WHITE-ICE-BOX/MARS-Reconfigurable-Multi-Task-Capable-Accelerator-for-Ultra-Low-Bit-Streaming-Inference/02_圖片原始檔/ch4/fig4.7_rc_in_hardware.pptx

RC In Hardware — Folded Into The Accumulator Initial Value

no extra adder / stage

“+ RC” adder

Window Start → sel init

hidden_acc
register

Stream in

M
U
X

hidden_act [1b]

Sign

Input
Buffer

[SIMD]

XNOR
[SIMD]

Popcount

+

Weights

Accumulate Loop

RC = initial value

Parameter Write
(From Function Switch Controller)

ram_down

ram_rc

The register must load an initial value every window anyway — RC simply replaces 0.
Datapath unchanged: 0 extra adders, 0 DSP, 0 pipeline stages. Cost = ram_rc storage only.
