WHITE-ICE-BOX/MARS-Reconfigurable-Multi-Task-Capable-Accelerator-for-Ultra-Low-Bit-Streaming-Inference/02_圖片原始檔/ch4/fig4.1_mars_soc.pptx

BUS

MARS NPU

DDR

SoC

Micro Processor

DDR Controller

Input DMA

Function Switch Controller

Output DMA
