WHITE-ICE-BOX/MARS-Reconfigurable-Multi-Task-Capable-Accelerator-for-Ultra-Low-Bit-Streaming-Inference/02_圖片原始檔/ch4/fig4.3_mars_arch.pptx

Configuration Bus

PS

Micro
Processor

Function
Switch
Controller

PL

MVAU8

DRAM

Output

Images

Super4

Super5

MVAU6

MVAU7

MaxPool

Super3

Super2

MaxPool

Super1

MVAU0
