WHITE-ICE-BOX/MARS-Reconfigurable-Multi-Task-Capable-Accelerator-for-Ultra-Low-Bit-Streaming-Inference/02_圖片原始檔/ch4/fig4.9_fsc_circuit.pptx

Function Switch Controller (adapter_cfg_hub.v)

MVAU0 Thresh

AWADDR[15:0]

Function Switch Controller

MVAU8 Cls Weights

AW latch

16

Unit decode
a[15:13]

3

WE demux
1-of-9

Super 1 Adapter

AWVALID

Unit-0 split
a[12]

9

Super 2 Adapter

WVALID

Write FSM

Word slice
a[12:2]

Super 3 Adapter

WDATA[31:0]

Configuration BUS
(waddr·wdata)

Super 4 Adapter

Super 5 Adapter

BRESP

MVAU6 Thresh

MVAU7 Thresh
