WHITE-ICE-BOX/MARS-Reconfigurable-Multi-Task-Capable-Accelerator-for-Ultra-Low-Bit-Streaming-Inference/02_圖片原始檔/ch5/fig5.1_hw_end2end.pptx

Model Construction

Frozen Backbone

Multi-Branch Adapter
with RC task #1

Multi-Branch Adapter
with RC task #N

Build AI Model

Train Backbone
+ Adapters

Evaluation

FINN Compiler

Model Deployment

Backbone IP

Super Wrapper

Function Switch Controller

⋮

Deploy
