WHITE-ICE-BOX/MARS-Reconfigurable-Multi-Task-Capable-Accelerator-for-Ultra-Low-Bit-Streaming-Inference/01_論文全文/figures/mb_tradeoff_compact_power.pdf

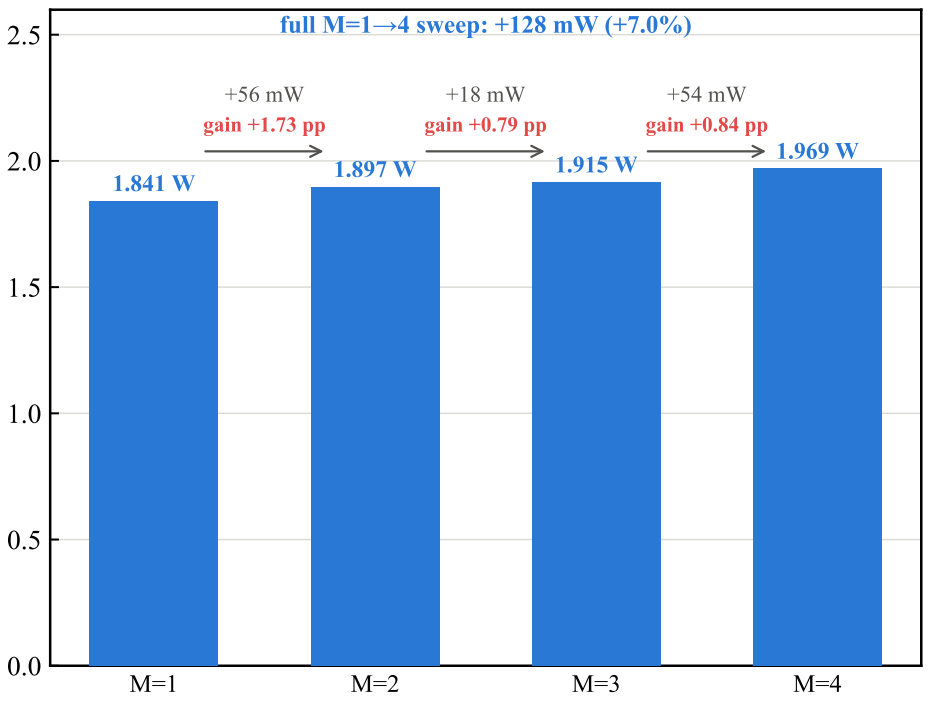
[picture p18: figure]
+56 mW gain +1.73 pp; +18 mW gain +0.79 pp; +54 mW gain +0.84 pp; full M=1 4 sweep: +128 mW (+7.0%)

### Total on-chip power (W, post-synthesis estimate)
