WHITE-ICE-BOX/MARS-Reconfigurable-Multi-Task-Capable-Accelerator-for-Ultra-Low-Bit-Streaming-Inference/01_論文全文/figures/mb_tradeoff_throughput_power.pdf

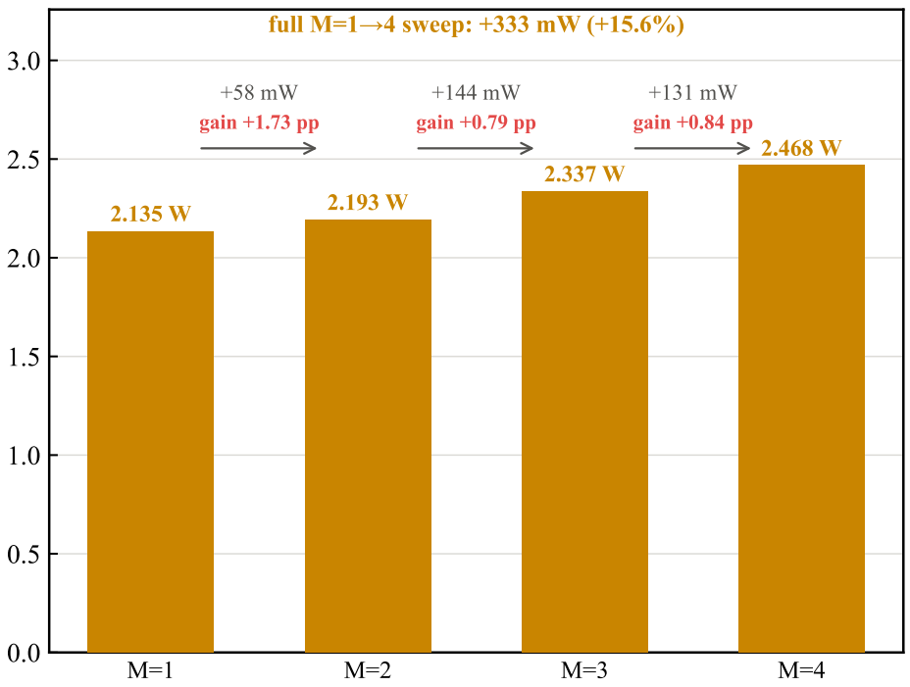
[picture p19: figure]
+58 mW gain +1.73 pp; +144 mW gain +0.79 pp; +131 mW gain +0.84 pp; full M=1 4 sweep: +333 mW (+15.6%)

### Total on-chip power (W, post-synthesis estimate)
