WHITE-ICE-BOX/MARS-Reconfigurable-Multi-Task-Capable-Accelerator-for-Ultra-Low-Bit-Streaming-Inference/07_碩士口試/README.md

# 07_碩士口試

- `黃柏鈞_MARS_口試簡報.pptx`：碩士論文口試簡報（最新版）。全英文、Times New Roman;涵蓋
  問題背景、MARS 方法（multi-branch adapter / RC / cfg_hub 任務切換）、實驗結果與跨平台比較、
  FPGA 量測條件與 SOTA 對照。
