WHITE-ICE-BOX/MARS-Reconfigurable-Multi-Task-Capable-Accelerator-for-Ultra-Low-Bit-Streaming-Inference/02_圖片原始檔/ch3/README.md

# ch3 圖片原始檔

架構示意圖編輯檔（pptx,已附）:

| Fig | 名稱 | 編輯檔 |
|---|---|---|
| 3.1 | sw_network | `fig3.1_sw_network.pptx` ✓ |
| 3.2 | sw_single_adapter | `fig3.2_sw_single_adapter.pptx` ✓ |
| 3.3 | sw_multiadapter | `fig3.3_sw_multiadapter.pptx` ✓ |
