WHITE-ICE-BOX/MARS-Reconfigurable-Multi-Task-Capable-Accelerator-for-Ultra-Low-Bit-Streaming-Inference/02_圖片原始檔/ch5/README.md

# ch5 圖片原始檔

| Fig | 名稱 | 編輯檔 |
|---|---|---|
| 5.1 | hw_end2end | `fig5.1_hw_end2end.pptx` ✓ |
| 5.2 | rc_mechanism | `rc_probe_fig5_2.py`（GPU 端探查）+ `plot_rc_mechanism_fig5_2.py`（繪圖）+ `rc_probe_out.json`（數據）✓ |
| 5.3 | mars_soc_layout | Vivado implemented design 截圖（Vivado GUI 匯出,非 pptx）|
| 5.4 | pe_diff | `fig5.4_pe_diff.pptx` ✓ |
| 5.5 / 5.6 | mb_tradeoff（4 圖）| `plot_fig5_4_5_5.py` ✓ |
