WHITE-ICE-BOX/MARS-Reconfigurable-Multi-Task-Capable-Accelerator-for-Ultra-Low-Bit-Streaming-Inference/02_圖片原始檔/ch4/README.md

# ch4 圖片原始檔

架構示意圖編輯檔（pptx,已附）。編號依論文正文圖號;其中 Fig 4.8、4.10、4.12 原為 TikZ 內嵌圖,
已自論文 `01_論文全文/MARS_碩士論文.tex` 抽出為可獨立編譯的 standalone `.tex` 原始檔
（`pdflatex 檔名.tex` 即可出圖）,內容與論文原始碼一致,無 pptx。

| Fig | 名稱 | 編輯檔 |
|---|---|---|
| 4.1 | mars_soc（fig42_mars_soc）| `fig4.1_mars_soc.pptx` ✓ |
| 4.2 | hw_finn_singletask_npu | `fig4.2_hw_finn_singletask_npu.pptx` ✓ |
| 4.3 | mars_arch（fig44_mars_arch）| `fig4.3_mars_arch.pptx` ✓ |
| 4.4 | hw_finn_mvau_wrapper | `fig4.4_hw_finn_mvau_wrapper.pptx` ✓ |
| 4.5 | hw_super_wrapper | `fig4.5_hw_super_wrapper.pptx` ✓ |
| 4.6 | hw_adapter_internal | `fig4.6_hw_adapter_internal.pptx` ✓ |
| 4.7 | rc_in_hardware | `fig4.7_rc_in_hardware.pptx` ✓ |
| 4.8 | cfg_hub 系統整合圖 | `fig4.8_cfghub_sys.tex`（TikZ standalone）✓ |
| 4.9 | fsc_circuit | `fig4.9_fsc_circuit.pptx` ✓ |
| 4.10 | cfg_hub 64KB 位址映射 | `fig4.10_cfghub_map.tex`（TikZ standalone）✓ |
| 4.11 | task_switch | `fig4.11_task_switch.pptx` ✓ |
| 4.12 | 部署成本 vs 任務/變體數（pgfplots）| `fig4.12_scaling_cost.tex`（TikZ standalone）✓ |
