WHITE-ICE-BOX/MARS-Reconfigurable-Multi-Task-Capable-Accelerator-for-Ultra-Low-Bit-Streaming-Inference/05_程式碼/FINN_Compile/README.md

# FINN_Compile — FINN end-to-end dataflow 合成

在 **FINN（Docker）** 內，把訓練好的 1W1A CNV backbone 從 Brevitas 匯出成 ONNX，再經 FINN 的
**streamline → 轉硬體層 → 折疊（folding）→ dataflow 合成**，產出每個 MVAU 的 memblock 與
**StreamingDataflowPartition IP**，作為 `RTL/` 整合 Adapter 的輸入。

> **FINN 本體未做任何修改**：使用官方 **FINN v0.9 Docker 原樣**。唯一客製在**最前端**——
> 載入的模型（`model/CNV.py` 自訓 1W1A 檢查點）與輸入前處理；其後 streamline、轉硬體層、
> 折疊、`ZynqBuild` **全部是官方轉換、與官方 `cnv_end2end_example` 相同**。本夾各 notebook
> 皆為該官方範例之衍生（僅前端載入不同、或折疊參數不同），並非多套流程。
> FINN **產出之 RTL** 的最小手動補丁（暴露 partial sum，`RTL/gen_scripts/patch_finn_ips.py`）
> 施加於產生碼快照上、在 FINN 之外進行——不修改 FINN 套件本身。

> **MVAU** = Matrix-Vector-Activation Unit（FINN 的卷積/全連接運算單元）。
> **folding / PE** = 平行折疊度；PE 越大越快、面積越大。throughput build 用異質高 PE，compact build 用 PE=1。

---

## 一、結構樹

```
FINN_Compile/
├── notebooks/                       # ── FINN end-to-end 流程（Jupyter）──
│   ├── pe1_cnv_end2end.ipynb        #  ★ 最終 compact(PE=1) 硬體的 backbone end2end（5資料集 build 用）
│   ├── pe1_adapter.ipynb            #  ★ 最終 compact(PE=1) 的 adapter 側 end2end
│   ├── cnv_end2end_example.ipynb    #    high-PE（throughput build）的 backbone end2end
│   └── adapter.ipynb                #    high-PE 的 adapter 側 end2end
├── model/                           # ── FINN 的輸入模型 ──
│   ├── CNV.py                       #    Brevitas CNV 定義（匯出成 ONNX 的來源）
│   └── cnv_6layer_fc3_cifar_w1a1.zip#    訓練好的 CIFAR-10 1W1A 模型（end2end 載入這個）
├── scripts/                         # ── 輔助腳本 ──
│   ├── verify_finn_stages.py        #    驗證 FINN 各階段 ONNX 輸出正確性
│   ├── verify_cifar1w1a.py          #    CIFAR-10 1W1A 端到端正確性檢查
│   ├── validate_custom.py           #    自訂資料集驗證
│   └── dump_canonical_cifar.py      #    匯出標準 CIFAR-10 測資供比對
└── onnx/                            # ── FINN 合成的關鍵中間/輸出 ONNX ──
    ├── end2end_cnv_w1a1_dataflow_model.onnx  #  dataflow 階段（含折疊資訊）
    └── end2end_cnv_w1a1_folded.onnx          #  折疊後模型（合成前最終形態）
```

★ = 產出論文最終硬體所用的關鍵檔。

---

## 二、「最終硬體」是用哪個 end2end？（實際部署對照）

**實際產出上板 bitstream 的只有四本**；逐格與建置樹比對後的部署脈絡：

| 最終 build（上板） | 實際使用的 notebook | 折疊 | 說明 |
|---|---|---|---|
| backbone, throughput | `cnv_end2end_example.ipynb` | 異質 PE（官方預設） | 官方範例原流程;所有後續模型之母體（build tree `finn_cifar10`） |
| **MARS, throughput, 2-task** | `adapter.ipynb` | 異質 PE | = 官方範例前端改載入 adapter 時代之 `model/CNV.py` 檢查點,其後步驟同官方 |
| backbone, compactness (PE=1) | `pe1_cnv_end2end.ipynb` | 均勻 PE=1 | = 官方範例之複製,**僅折疊表改全 PE=1**（載入同一 `dataflow_model.onnx` 重折疊）;以 `jupyter nbconvert --execute` 無頭執行 |
| **MARS, compactness, N-task** | `pe1_adapter.ipynb` | 均勻 PE=1 | = `adapter.ipynb` 之 PE=1 對應版（22 格中 20 格相同,僅折疊不同） |

> 本夾**只保留實際產出上板 bitstream 的四本 notebook**。早期未用於部署的檔案（`backbone_cifar.ipynb` broken legacy、`pe1_refold_from_v1.py` 早期 refold 嘗試）已移除,避免誤導;PE=1 折疊實際在 `pe1_cnv_end2end.ipynb` 的折疊 cell 內完成。

---

## 三、完整 FINN 階段（ONNX 命名對應）

```
export → tidy → streamlined → (convert to HW layers) → folded → dataflow_model → synth
```
本資料夾只保留 `dataflow_model` 與 `folded` 兩個關鍵 ONNX（其餘中間檔與 Vivado `code_gen`
產物數十 GB，未收錄）。完整重跑請在 FINN Docker 內依 `notebooks/` 執行。

---

## 四、與 RTL 的銜接

FINN 產出每個 MVAU 的 memblock `.dat` 與 StreamingDataflowPartition IP 之後，`RTL/` 會把
MVAU1–5 各包一層 Adapter「Super Wrapper」、加入 `cfg_hub`，再以 `RTL/tcl/` 打包成 Vivado IP，
最後由 `SoC/` 縫合成 bitstream。
