WHITE-ICE-BOX/MARS-Reconfigurable-Multi-Task-Capable-Accelerator-for-Ultra-Low-Bit-Streaming-Inference/02_圖片原始檔/ch3/fig3.1_sw_network.pptx

Multi – Branch Adapter , RC

Conv2

Multi – Branch Adapter , RC

Conv3

Multi – Branch Adapter , RC

Conv4

Input

Conv1

MaxPool

MaxPool

Conv5

Conv6

FC1

FC2

LS

Output

Multi – Branch Adapter , RC

Multi – Branch Adapter , RC
