WHITE-ICE-BOX/MARS-Reconfigurable-Multi-Task-Capable-Accelerator-for-Ultra-Low-Bit-Streaming-Inference/02_圖片原始檔/ch3/fig3.3_sw_multiadapter.pptx

Down-projection

Sign

Up-projection

scale

× α1

sum

Cin

1×1 binary conv

b1 (RC)

binarize

1×1 binary conv

z⁽¹⁾

Cout

Ch = Cin / 4

b2 (RC)

z⁽²⁾

× α2

Σ

⋮

bM (RC)

z(M)

× αM
