WHITE-ICE-BOX/MARS-Reconfigurable-Multi-Task-Capable-Accelerator-for-Ultra-Low-Bit-Streaming-Inference/02_圖片原始檔/ch4/fig4.5_hw_super_wrapper.pptx

Super Wrapper

Modified MVAU Core
Binary Conv (XNOR-Popcount)

Splitter
Duplicate

Adder + Threshold
Sum Two Streams → 1-bit out

INPUT
Stream

OUTPUT
Stream

Adapter
Down→Sign→Up, +RC

FIFO
Sync

Multi-Branch Adapter — M parallel branches (M = 1–4)
