WHITE-ICE-BOX/MARS-Reconfigurable-Multi-Task-Capable-Accelerator-for-Ultra-Low-Bit-Streaming-Inference/02_圖片原始檔/ch4/fig4.6_hw_adapter_internal.pptx

s_axis_tvalid

s_axis_tdata

m_axis_tready

Control Unit

Adapter Memories (RAM)

ram_down

ram_rc

ram_up

contrib_lut

Adapter Datapath

[SIMD]

Input Buffer

XNOR + popcount (down)

Accumulator + RC

Sign → hidden_act

XNOR + popcount (up)

α-LUT → contrib

[SIMD]

s_axis_tready

[16b]

cfg_wen

cfg_waddr [11]

cfg_wdata [32]

[HIDDEN]

[HIDDEN]

m_axis_tvalid

m_axis_tdata

[32b]

[8b]
