WHITE-ICE-BOX/MARS-Reconfigurable-Multi-Task-Capable-Accelerator-for-Ultra-Low-Bit-Streaming-Inference/05_程式碼/AI_model_train/results/README.md

# results/ — 軟體實驗數據對照

> **數字對照**：各 `results/*.csv` 為 runner 原始輸出;`final_accuracy_summary.txt` 為彙整索引（從訓練 log
> 擷取的 Final Best Accuracy）。各 `results.csv` 為各 runner 的原始批次輸出，**僅供原始紀錄**；
> 論文數據以成功列與〈論文對應表〉為準;探索性或被取代之幾何列保留供 provenance。

## 一、資料夾 → 論文表 對照

| 資料夾 | 對應內容（論文） | 幾何 |
|---|---|---|
| `results.csv`（頂層） | CIFAR-10→SVHN 1-bit：adapter 73.72 / full-FT 94.91 / bit-sweep | — |
| `cifar10_configC_bits{,_rc}/` | CIFAR→targets 位元寬度掃描（單 Adapter no-RC / 含 RC） | 寬版（wide） |
| `cifar10_configC_cross/` | CIFAR backbone → 各 target 1-bit 多分支 Adapter | 寬版（wide） |
| `cifar10_to_others_bits/` | CIFAR→targets 位元掃描（含 full-FT 上界） | — |
| `svhn_to_others_bits/` | 跨來源位元寬度掃描 | — |
| `a6000_crosssource/*_configC_cross/` | **跨來源 1-bit 多分支 Adapter（Table「跨來源多分支 Adapter」）** | 寬版（wide） (mid='out') |
| `configC_sw_multi/` | 軟體多分支 Adapter 補格（CIFAR→{Fashion,STL10,CINIC10}, M2–4） | 寬版（wide） |
| `v6/ v_v6_bit/ v_v6_cross/ v_v6_cross_m/` | 寬版（wide）幾何（v6）各掃描 | 寬版（wide） |
| `v7_multi_rc/` | 多分支 Adapter × RC 開關消融；**deployed(v1v2) SVHN M1–4=73.72/77.16/78.77/79.81** | 寬版（wide） + deployed |
| `v9_cross_dataset/` | **deployed 跨資料集（CINIC10 M2–4=65.16/65.38/65.45）** | deployed |
| `v9_ft_baseline/ v9ft_cross_bit/` | full-FT 上界（1-bit 與位元寬度） | — |
| `v3_compare/ v3_compare_50ep_*/` | kernel 3×3 vs 1×1 單軸消融 | — |
| `v_seed/` | n=3 multi-seed 變異 | — |
| `b2_significance/` | n=5 paired t-test 顯著性 | deployed |
| `{svhn,stl10,fashionmnist}_to_others/` | **雙重角色**：`full_ft` 列＝Table 5.4 full-FT 欄來源（**採用**，如 SVHN→CIFAR10=81.70）；`adapter` 列為 mid='in'（**已被 configC 取代，勿用於多分支 Adapter 表**） | full_ft 採用 / adapter mid='in' 棄用 |

## 二、幾何（geometry）說明

- **寬版（wide）**（軟體參考（寬版））：kernel 3×3、mid='out'（Cout/4）、α per-channel。`configC` / `v6` 家族。
- **deployed**（FPGA 部署版）：kernel 1×1、mid='in'（Cin/4）、α scalar。`v9` 家族 + `b2`。
- `*_to_others/` 的 **adapter 列**是早期 **mid='in'** 跨來源跑，與論文 Table（寬版（wide）/mid='out'）
  幾何不同、數值也不同（例 SVHN→CINIC10 M4：mid='in'=36.7 vs 寬版（wide）=39.70），故 adapter 列**不採用**；
  但同資料夾的 **full_ft 列**為 Table 5.4 full-FT 欄之來源（**採用**）。跨來源多分支 Adapter 數值請看
  `a6000_crosssource/*_configC_cross/`（mid='out'）。

## 三、已知資料衛生問題（誠實標註）

- **headline 數字部分只在 summary**：如 寬版（wide） SVHN M4 = **84.44%**、CINIC10 M4 = **65.02%**
  為 seed-2024 單次跑，記錄於 `final_accuracy_summary.txt` 與 log，**未進結構化 CSV**。
- **探索/provenance 列**：少數早期或被取代之幾何列（`acc=0.0` 等）保留供追溯;論文值以對應表列為準。
- **`configC_sw_multi/results.csv`** 無 SVHN 列、CINIC10 M4 為空（補格用，SVHN 主表在 `v7_multi_rc`）。

---

## A6000 批次增補（論文定稿版新增，2026-07 同步）

| 目錄 | 對應論文 | 說明 |
|---|---|---|
| `b2_significance/` | Table 5.6、§5.2.5 | SVHN/FashionMNIST × M1/M4 × 5 seeds（2024–2028）配對檢定原始值 |
| `table56_5seed/` | Table 5.5 | Full-FT 與 MARS M4+RC 各 5 seeds |
| `{svhn,stl10,fashionmnist,cinic10}_configA_cross/` | Table 5.18（部署 20 對之 16 對） | 各來源 backbone × 4 targets × M1–4（RC on）；CIFAR-10 來源之 4 對見 `v9_cross_dataset/` |
| `*_configA_bits_rc/` | Table 5.8–5.10 佐證 | 部署幾何 RC 消融跨位元 |
| `fashionmnist_configA_verify/`、`fashionmnist_configC_SVHN_{200ep,verify}/` | §5.3.4 | FMNIST→SVHN 幾何反轉之獨立重跑／seed2025／50ep 驗證（舊 45.68 重複值＝best-epoch 峰值碰撞，論文 Table 5.4 † 註） |
| `cinic10_configC_{cross,bits_rc}/` | Table 5.4、3.2 | CINIC10 來源寬版掃描與位元掃描 |

注:2-bit 批次（`*_configC_cross2`,BIT=2）非論文數據,本 release 僅收錄論文相關之 1/2/4/8-bit 結果。

## 溯源(provenance)

- 所有 CSV 為 runner 直接輸出之原始值(未手改);對應 runner 之超參數(seed、epochs、lr、幾何旗標)寫死於 `runners/*.py` 內,即為該批數據之完整 configuration metadata。
- 訓練皆 200 epochs、STEP(100,150)、lr 0.005、batch 100;headline 用 seed 2024,多 seed 批次為 2024–2028。
- 本 release 對應之論文版本:碩士論文定稿(2026-07);程式碼與數據之對應以 git tag/commit 為準。
