WHITE-ICE-BOX/MARS-Reconfigurable-Multi-Task-Capable-Accelerator-for-Ultra-Low-Bit-Streaming-Inference/05_程式碼/AI_model_train/results/a6000_crosssource/b2_significance/results.csv

dataset | M | seed | best_acc
SVHN | 1 | 2024 | 73.01014136447449
