WHITE-ICE-BOX/MARS-Reconfigurable-Multi-Task-Capable-Accelerator-for-Ultra-Low-Bit-Streaming-Inference/05_程式碼/AI_model_train/results/a6000_crosssource/cinic10_configC_bits_rc/results.csv

dataset | bit | mode | acc | params | returncode
CIFAR10 | 8 | adapter_rc | 90.54 | 1875423 | 0
FashionMNIST | 8 | adapter_rc | 93.77 | 1875423 | 0
STL10 | 8 | adapter_rc | 74.19 | 1875423 | 0
SVHN | 8 | adapter_rc | 95.72 | 1875423 | 0
