WHITE-ICE-BOX/MARS-Reconfigurable-Multi-Task-Capable-Accelerator-for-Ultra-Low-Bit-Streaming-Inference/05_程式碼/AI_model_train/results/a6000_crosssource/fashionmnist_configA_bits_rc/results.csv

dataset | bit | mode | acc | params | returncode
CINIC10 | 1 | adapter_rc | 27.75 | 1605223 | 0
CINIC10 | 2 | adapter_rc | 32.55 | 1605231 | 0
CINIC10 | 4 | adapter_rc | 37.73 | 1605231 | 0
CINIC10 | 8 | adapter_rc | 39.14 | 1605231 | 0
