WHITE-ICE-BOX/MARS-Reconfigurable-Multi-Task-Capable-Accelerator-for-Ultra-Low-Bit-Streaming-Inference/05_程式碼/AI_model_train/results/a6000_crosssource/fashionmnist_configA_cross/results.csv

dataset | mode | M | rc | acc | params | returncode
CINIC10 | adapter | 1 | True | 27.75 | 1605223 | 0
CINIC10 | adapter | 2 | True | 28.37 | 1663756 | 0
CINIC10 | adapter | 3 | True | 29.55 | 1722289 | 0
CINIC10 | adapter | 4 | True | 29.56 | 1780822 | 0
