WHITE-ICE-BOX/MARS-Reconfigurable-Multi-Task-Capable-Accelerator-for-Ultra-Low-Bit-Streaming-Inference/05_程式碼/AI_model_train/results/a6000_crosssource/fashionmnist_configC_bits_rc/results.csv

dataset | bit | mode | acc | params | returncode
CINIC10 | 1 | adapter_rc | 0.0 | 1875410 | 1
CINIC10 | 2 | adapter_rc | 0.0 | 1875423 | 1
CINIC10 | 4 | adapter_rc | 67.65 | 1875423 | 0
CINIC10 | 8 | adapter_rc | 68.84 | 1875423 | 0
