WHITE-ICE-BOX/MARS-Reconfigurable-Multi-Task-Capable-Accelerator-for-Ultra-Low-Bit-Streaming-Inference/01_論文全文/figures/mb_tradeoff_compact_lut.pdf

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

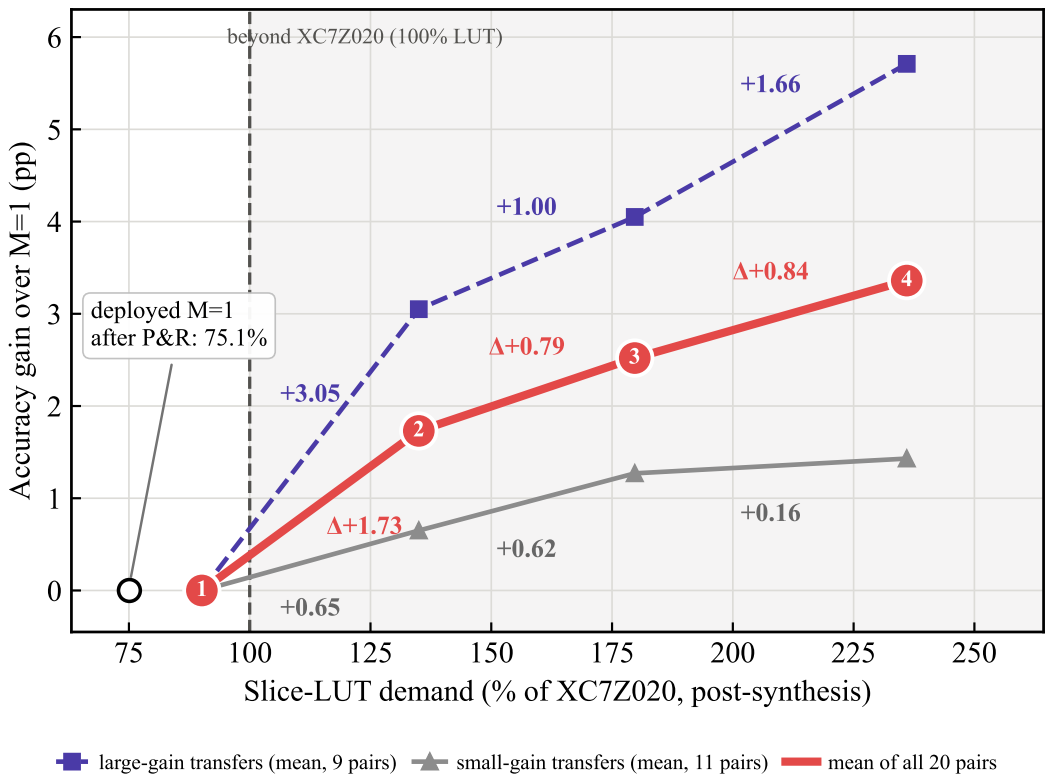
[picture p31: page 1]
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
