WHITE-ICE-BOX/MARS-Reconfigurable-Multi-Task-Capable-Accelerator-for-Ultra-Low-Bit-Streaming-Inference/01_論文全文/figures/mb_tradeoff_throughput_lut.pdf

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

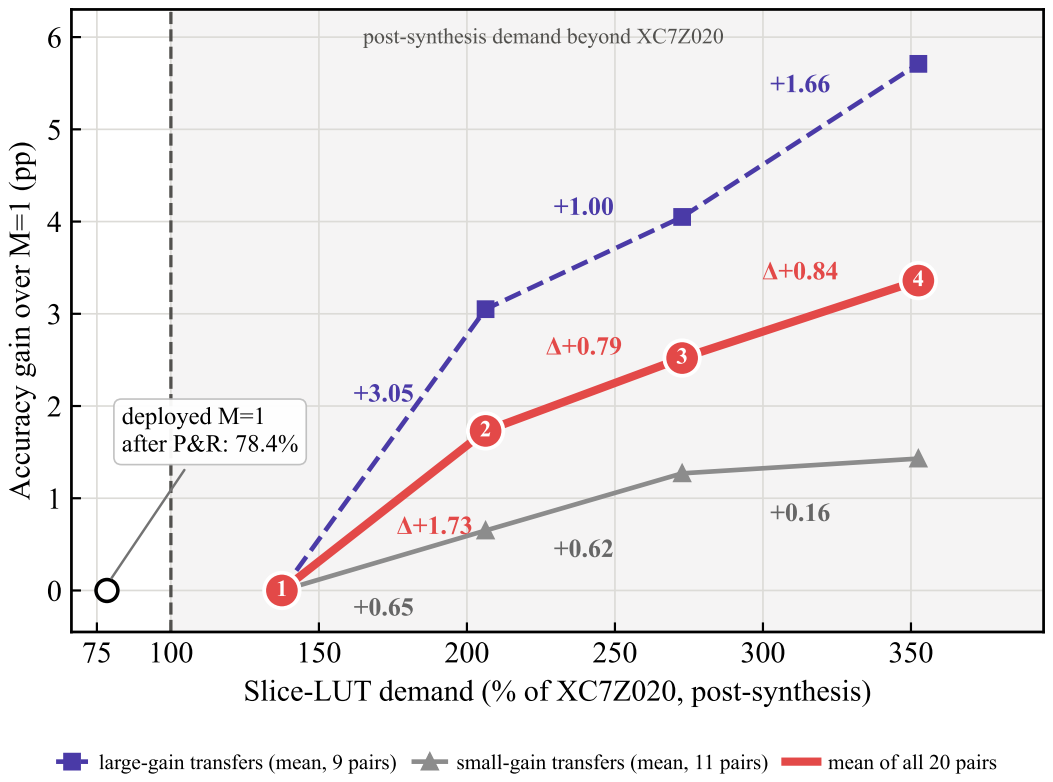
[picture p32: page 1]
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
