WHITE-ICE-BOX/MARS-Reconfigurable-Multi-Task-Capable-Accelerator-for-Ultra-Low-Bit-Streaming-Inference/05_程式碼/RTL/super_wrapper/Stream_Adder_Threshold_mvau5.v

`timescale 1ns / 1ps

// =====================================================================
// MVAU5 Stream_Adder_Threshold — PE=1 version, polarity XOR formula
// OUT_CH=256, K=2304 (popcount range = 256*3*3)
//   adjusted_pop = pol[ch] ? (K - mvau_pop) : mvau_pop
//   total_q8 = (adjusted_pop << 8) + contrib
//   result_bit = (total_q8 >= thresh) XOR pol[ch]
// =====================================================================

module Stream_Adder_Threshold_mvau5 (
    input  wire                  aclk,
    input  wire                  aresetn,

    input  wire [31:0]           s_axis_1_tdata,
    input  wire                  s_axis_1_tvalid,
    output wire                  s_axis_1_tready,

    input  wire [7:0]            s_axis_2_tdata,
    input  wire                  s_axis_2_tvalid,
    output wire                  s_axis_2_tready,

    output reg                   m_axis_tdata,
    output reg                   m_axis_tvalid,
    input  wire                  m_axis_tready,

    input  wire [10:0]           cfg_waddr,
    input  wire [31:0]           cfg_wdata,
    input  wire                  cfg_wen,
    input  wire                  adapter_enable
);
    parameter OUT_CH = 256;
    parameter K_TOTAL = 2304;

    (* ram_style = "distributed" *) reg signed [31:0] thresh_rom      [0:OUT_CH-1];
    (* ram_style = "distributed" *) reg               adp_sign_rom    [0:OUT_CH-1];  // polarity
    (* ram_style = "distributed" *) reg signed [31:0] adp_contrib_lut [0:255];

`ifdef SIM_INIT_ROM
    initial begin
        $readmemh("/home/barkie1/mvau_pipeline_runtime_3ds_pe1/mvau_adapter/mvau5/data/thresh_load.dat",      thresh_rom);
        $readmemh("/home/barkie1/mvau_pipeline_runtime_3ds_pe1/mvau_adapter/mvau5/data/sign_load.dat",        adp_sign_rom);
        $readmemh("/home/barkie1/mvau_pipeline_runtime_3ds_pe1/mvau_adapter/mvau5/data/contrib_lut_load.dat", adp_contrib_lut);
    end
`endif

    localparam CFG_THRESH_BASE = 11'd1152;
    localparam CFG_SIGN_BASE   = 11'd1408;
    localparam CFG_LUT_BASE    = 11'd1664;

    // ch counter uses ceil_log2(OUT_CH)=8
    reg [$clog2(OUT_CH)-1:0] ch_cnt;
    // cfg_waddr is 11 bits — but thresh/sign for OUT_CH=256 fit since base 1152+256=1408, sign 1408+256=1664, lut 1664+256=1920 (all <2048)
    always @(posedge aclk) begin
        if (cfg_wen) begin
            if (cfg_waddr >= CFG_THRESH_BASE && cfg_waddr < CFG_THRESH_BASE + OUT_CH)
                thresh_rom[cfg_waddr - CFG_THRESH_BASE] <= $signed(cfg_wdata);
            if (cfg_waddr >= CFG_SIGN_BASE && cfg_waddr < CFG_SIGN_BASE + OUT_CH)
                adp_sign_rom[cfg_waddr - CFG_SIGN_BASE] <= cfg_wdata[0];
            if (cfg_waddr >= CFG_LUT_BASE && cfg_waddr < CFG_LUT_BASE + 256)
                adp_contrib_lut[cfg_waddr - CFG_LUT_BASE] <= $signed(cfg_wdata);
        end
    end

    wire stall = m_axis_tvalid && !m_axis_tready;
    wire in_fire = s_axis_1_tvalid && s_axis_2_tvalid && !stall;
    assign s_axis_1_tready = !stall && s_axis_2_tvalid;
    assign s_axis_2_tready = !stall && s_axis_1_tvalid;

    reg                    s1_valid;
    reg signed [31:0]      s1_mvau_pop;
    reg signed [31:0]      s1_adp_contrib;
    reg signed [31:0]      s1_threshold;
    reg                    s1_pol;

    reg                    s2_valid;
    reg signed [31:0]      s2_total_q8;
    reg signed [31:0]      s2_threshold;
    reg                    s2_pol;

    always @(posedge aclk) begin
        if (!aresetn) begin
            ch_cnt <= 0;
            m_axis_tvalid <= 0; m_axis_tdata <= 0;
            s1_valid <= 0; s2_valid <= 0;
        end else if (!stall) begin
            // Stage 3: compare with XOR pol
            if (s2_valid) begin
                m_axis_tvalid <= 1'b1;
                m_axis_tdata  <= ((s2_total_q8 >= s2_threshold) ? 1'b1 : 1'b0) ^ s2_pol;
            end else begin
                m_axis_tvalid <= 1'b0;
            end

            // Stage 2: compute adjusted_pop and total_q8
            if (s1_valid) begin
                s2_valid <= 1'b1;
                if (adapter_enable) begin
                    if (s1_pol)
                        s2_total_q8 <= (($signed(K_TOTAL) - s1_mvau_pop) <<< 8) + s1_adp_contrib;
                    else
                        s2_total_q8 <= (s1_mvau_pop <<< 8) + s1_adp_contrib;
                end else begin
                    if (s1_pol)
                        s2_total_q8 <= ($signed(K_TOTAL) - s1_mvau_pop) <<< 8;
                    else
                        s2_total_q8 <= s1_mvau_pop <<< 8;
                end
                s2_threshold <= s1_threshold;
                s2_pol       <= s1_pol;
            end else begin
                s2_valid <= 1'b0;
            end

            // Stage 1: capture & lookup
            if (in_fire) begin
                s1_valid       <= 1'b1;
                s1_mvau_pop    <= $signed(s_axis_1_tdata);
                s1_adp_contrib <= adp_contrib_lut[s_axis_2_tdata];
                s1_threshold   <= thresh_rom[ch_cnt];
                s1_pol         <= adp_sign_rom[ch_cnt];

                if (ch_cnt == OUT_CH - 1) ch_cnt <= 0;
                else                       ch_cnt <= ch_cnt + 1;
            end else begin
                s1_valid <= 1'b0;
            end
        end
    end

endmodule
