WHITE-ICE-BOX/MARS-Reconfigurable-Multi-Task-Capable-Accelerator-for-Ultra-Low-Bit-Streaming-Inference/(commit log)

2026-06-25 Add inline onboarding comments (conv/multi adapter, cfg_hub, runtime switch); runtime_3ds supports all 5 datasets
2026-07-18 Sync release with final thesis: deployed RTL, all experiment runners/results, figure scripts, terminology
    - RTL/: promote deployed compactness N-task variant (cfg-writable adapter weights/RC/LUT) as
    primary; cfg_hub updated to the 8-unit/9-destination decoder matching thesis Sec 4.5; old
    throughput-variant files and 5-port cfg_hub preserved under RTL/variant_throughput/
    - AI_model_train/: sync trainer to the multi-branch-capable version; add A6000 runners
    (configA 20-pair sweep, b2 5-seed significance, table56, FMNIST verify set, CINIC10) and
    all corresponding results CSVs
    - Figures_Analysis/ (new): RC mechanism probe + Fig 5.2 plotter, Fig 5.4/5.5 plotter,
    selection-free last-epoc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
    [results.csv, s2025.csv, svhn200.csv, table56.csv, verify.csv]
2026-07-18 Remove unused code to avoid confusion; label everything that remains
    Deleted (not part of the final-thesis flow):
    - FINN_Compile/notebooks/backbone_cifar.ipynb (broken legacy; correct flow is cnv_end2end_example)
    - FINN_Compile/scripts/pe1_refold_from_v1.py (early refold attempt, never reached deployment;
    the PE=1 folding is done inside pe1_cnv_end2end.ipynb)
    - AI_model_train/runners/fmnist_retrain_v2.py (deprecated orchestrator with known bugs)
    - AI_model_train/runners/_b2_runner.py (retired-4090 duplicate of _b2_a6_runner.py)
    - AI_model_train/runners/run_config{A,C}_cross_nf.py (no-finetune variants, no results, unused)
    Updated READMEs: drop the removed entries from the FINN tree and ru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
2026-07-18 Audit fixes: supply 43,520 golden vectors, fix misplaced throughput reports, honest reproducibility statement
    - RTL/verification: add all five per-MVAU golden .dat (expected vectors total exactly 43,520,
    matching thesis Sec 4.7); testbenches now use relative golden_data/ paths; add manifest.csv
    - FPGA/results: the three MARS_throughput_2ds routed reports were byte-identical copies of
    backbone_throughput (misplaced); removed and replaced with REPORT_MISSING.md stating the
    correct paper values and that the source Vivado run was not archived; add SHA256SUMS.txt
    - README: fix table-number typos (5.2->5.1 datasets; split 5.8 wide/deployed from 5.9-5.10 RC),
    stop over-claiming full reprodu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
    [manifest.csv]
2026-07-18 Make data-producing scripts run from a clean clone
    - collect_tables.py: ROOT now resolves to the in-repo Synth_Sweep (MARS_SYNTH_ROOT override)
    - plot_final4.py (Fig 5.4/5.5): savefig -> ./fig_out (auto-created); header documents the
    embedded values' source and that collect_tables.py can recompute them
    - gen_3ds_cfg.py: parameterize checkpoint/Brevitas paths; header notes the finished payloads
    already ship in runtime_weights/ and regeneration needs the (large, unshipped) checkpoints
    - rc_probe_fig5_2.py: output path unified to rc_probe_out.json (matches the shipped JSON)
    - remove board_switch_fast_bench.py (imported a non-existent runtime_3ds_fast; the fast path
    is known to corrupt ada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
2026-07-18 README: fix dead links to removed fast-bench; add 'running new experiments' quick guide
    - Point Table 5.22/5.23 and deployment steps at board_test_v3force.py (the real switch-latency
    entry via RuntimeSwitcher.switch()) instead of the removed board_switch_fast_bench.py
    - Add Section 9.6: flag-by-flag guide so a new student can run a new configuration by changing
    one CLI flag (dataset/backbone/M/RC/geometry/bit-width/seed), how runners batch them, how to
    add a dataset or a new hardware branch variant. All paths resolve from a clean clone.
2026-07-18 Teach navigating FINN-generated RTL; make patch_finn_ips glob-robust
    - patch_finn_ips.py: replace the hardcoded 8-char ipgen hash suffixes with wildcards +
    _resolve() (the hash changes every FINN build); FINN_CODEGEN_DIR env override
    - RTL/README appendix 'FINN 生成碼導覽': stable module-naming table (MVAU_hls_N <-> thesis
    units), which parts are random per-build (hash suffix -> use glob), the three signal classes
    to locate (AXI-Stream boundary out_V_T*, raw partial sum, threshs/weights ROM) with grep
    commands, and tools (Netron on the folded ONNX, patch_finn_ips as the worked example)
    [patch_finn_ips.py]
2026-07-18 Recover cross-platform GPU/Jetson benchmark suite from RTX 4090 host (Table 5.19/5.20)
    Previously flagged as retired/non-reproducible; retrieved from the 4090 workspace and added
    under Cross_Platform/ with paths sanitized:
    - gpu_rtx4090/: benchmark_svhn.py (build_svhn_loader + NVML PowerMonitor + timing),
    benchmark_svhn_10x.py / benchmark_cifar_10x.py (backbone & M=1 adapter, batch1000 x10),
    bench_convadapter_k3_10x.py (the prior-art 3x3 wide Conv-Adapter GPU baseline for the
    cross-platform tables), _b1_tables.py (aggregation), _b1_bestof/_autoidle (clean-window)
    - jetson_nano/: benchmark.py, benchmark_svhn.py
    Documents the batch-1000/n=10 protocol, the different-geometry caveat, and t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
2026-07-18 README: cross-platform GPU/Jetson scripts recovered (no longer 'non-reproducible')
    Section 11 now reflects that the Table 5.19/5.20 measurement scripts were retrieved from the
    4090 host into Cross_Platform/ (protocol re-runnable on equivalent hardware); only the raw
    stdout logs remain unsaved. The MARS-throughput Vivado report and five-task deployment
    checkpoints stay flagged (Vivado artifact not on the GPU host; payloads already ship in
    runtime_weights/).
2026-07-18 Docs: frame all large build artifacts as reproduced-by-steps, not as gaps
    Rewrite Section 10 (validation scope) and Section 11 (how large build artifacts are produced:
    Vivado reports, GPU/Jetson measurements, on-board logs, payloads/probe — all with scripts,
    env versions and step-by-step guides in place). Neutralize Cross_Platform and results READMEs
    and REPORT_NOTE. The message throughout: all code, tool versions and steps are provided;
    large build artifacts are regenerated by running the documented flow.
2026-07-18 New-user walkthrough fixes: parameterize gen_scripts, fix README order and steps
    Dogfooding a fresh clone surfaced:
    - gen_scripts (prepack_adapter_dat, make_adp_contrib_luts, generate_mvau1234_golden,
    generate_thresh_q8_mvau5, final_sw) had hardcoded mvau_pipeline/ paths -> now MARS_DAT_SRC /
    MARS_CKPT env vars defaulting into the repo (packed .dat already ship in RTL/hardware_assets;
    RC_m1_full.tar ships in gen_scripts/); headers note the outputs already ship
    - README 9.3: add 'pip install -r requirements.txt' as the first step
    - README 9.4: state packed .dat/blobs already ship; gen_scripts are for regeneration
    - README: move Section 11 back above License/Citation (was after them)
    [final_sw.py, generate_mvau1234_golden.py, generate_thresh_q8_mvau5.py, make_adp_contrib_luts.py, prepack_adapter_dat.py]
2026-07-18 Restructure into thesis handover package (01-07 + top README)
    Reorganize the repo into the standard handover layout: code moved under 05_程式碼/, plus
    01_論文全文 (thesis tex/PDF), 02_圖片原始檔 (per-figure editable sources; python plot scripts
    included, architecture-pptx placeholders per chapter with a full figure-to-source table),
    03_期刊論文 / 04_會議論文 (IEEEtran tex+PDF), 06_資料集 (dataset sources/links), 07_碩士口試
    (defense slides). Each folder has its own README; top README indexes everything.
    [manifest.csv, results.csv, s2025.csv, svhn200.csv, table56.csv, verify.csv]
2026-07-18 Tidy 01/03/04: keep only English-watermark PDF, rename files to thesis names
    - 01_論文全文: remove all stray files (reference PDFs, review diffs, old builds, intermediate
    images) that were copied in by mistake; keep MARS_碩士論文.tex + the 21 figures it uses +
    MARS_碩士論文.pdf (English watermarked final); verified it compiles (120 pp, 0 undefined,
    no missing figures)
    - 03_期刊論文: drop duplicate/misplaced PDFs; rename to MARS_期刊論文.{tex,pdf}
    - 04_會議論文: rename to MARS_會議論文.{tex,pdf}
    - update the three READMEs to the new filenames
2026-07-20 Update oral-defense slides (07) to latest MARS presentation
    Replace 07_碩士口試/黃柏鈞_MARS_口試簡報.pptx with the current
    黃柏鈞_MARS.pptx from the final-version set.
    Claude-Session: https://claude.ai/code/session_01AXwvcSuLPmu2dtSTfo9xRy
2026-07-20 Add standalone TikZ sources for embedded ch4 figures (4.8, 4.10, 4.12)
    Extract the three figures that were drawn inline with TikZ in
    MARS_碩士論文.tex into independent, compilable standalone .tex sources,
    so every ch4 figure has an editable source file alongside the pptx ones:
    - fig4.8_cfghub_sys (System-Level Integration of the FSC)
    - fig4.10_cfghub_map (cfg_hub 64KB Address Map)
    - fig4.12_scaling_cost(Deployment Cost vs. Task/Variant Count, pgfplots)
    Thesis source is left untouched; these are copies only.
    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
2026-07-20 Clarify board-test script names per build in 05 top-level README
    board_test_10k.py exists only in the compact build
    (MARS_compact_5ds_pe1). The throughput build (MARS_throughput_2ds)
    uses batch_test.py (throughput) and board_test.py (accuracy).
    Fix the Table 5.19/5.20 mapping row and the §9.4 deployment step so
    the top-level summary distinguishes the two builds; per-folder
    FPGA/README.md files were already correct.
    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
2026-07-20 Revert thesis title to original, fix advisor name, integrate figure-source pptx
    - Revert title (per dropped committee request) across 01/03/04 tex + all READMEs:
    EN "MARS: A Reconfigurable Multi-Task-Capable Accelerator Architecture for
    Ultra-Low-Bit Streaming Inference"; ZH 具多任務能力…可重組加速器架構
    - Fix advisor name Chun-Hsien -> Chun-Hsian
    - Recompile 01/03/04 PDFs in place so each repo .tex matches its own .pdf
    - Add 14 architecture-diagram pptx sources into 02_圖片原始檔 by thesis figure
    number (fsc_circuit=4.9, task_switch=4.11); refresh figure-source READMEs
    - .gitignore: exclude private oral-defense folder and *.xdv
    - Font/compile prerequisites (XeLaTe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
